Kn1ghtHOK/random/README.md

# random

## [MIB Neuralizer](neuralizer/): 3D-printable, light-up, no hardware

A parametric Men in Black neuralizer for a Bambu Lab P1S in PETG:
- **Sleeve:** the fluted sleeve slides open and a clear window under the dome glows red.
- **Button:** press HOURS for a white flash through the same window.
- **Hardware:** printed threads, snap-fits and a printed battery spring. No screws, springs, magnets or glue.

| | |
|---|---|
| **Print** | [`neuralizer/3mf/neuralizer_P1S_PETG_project.3mf`](neuralizer/3mf/neuralizer_P1S_PETG_project.3mf): Bambu Studio project with 5 plates and AMS slots 1 white / 2 black / 3 clear. Per-part 3MFs are in [`neuralizer/3mf/parts`](neuralizer/3mf/parts). |
| **Assemble** | [neuralizer/ASSEMBLY.md](neuralizer/ASSEMBLY.md): 11 illustrated steps |
| **Details** | [neuralizer/BUILD_GUIDE.md](neuralizer/BUILD_GUIDE.md): assumptions, shopping list, wiring, finish, fit tuning |
| **Proof** | [neuralizer/VERIFICATION.md](neuralizer/VERIFICATION.md): collisions, threads, mechanisms, overhangs, 3MF validation |
| **Model** | [neuralizer/neuralizer.scad](neuralizer/neuralizer.scad) (OpenSCAD Customizer) |

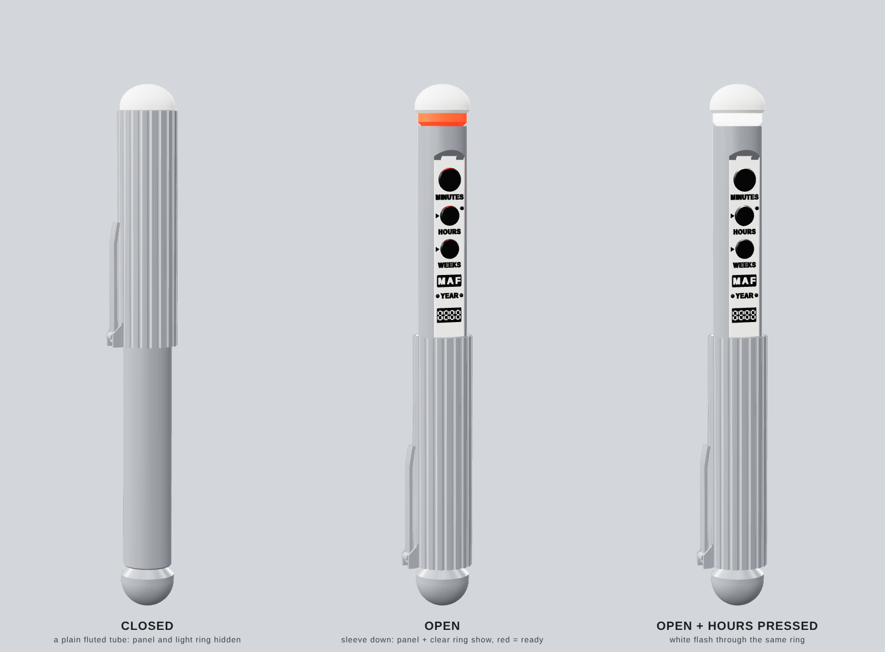
[picture p1: neuralizer/images/preview_closed_open.png]
preview
