Kn1ghtHOK/random/neuralizer/images/window_and_back.png

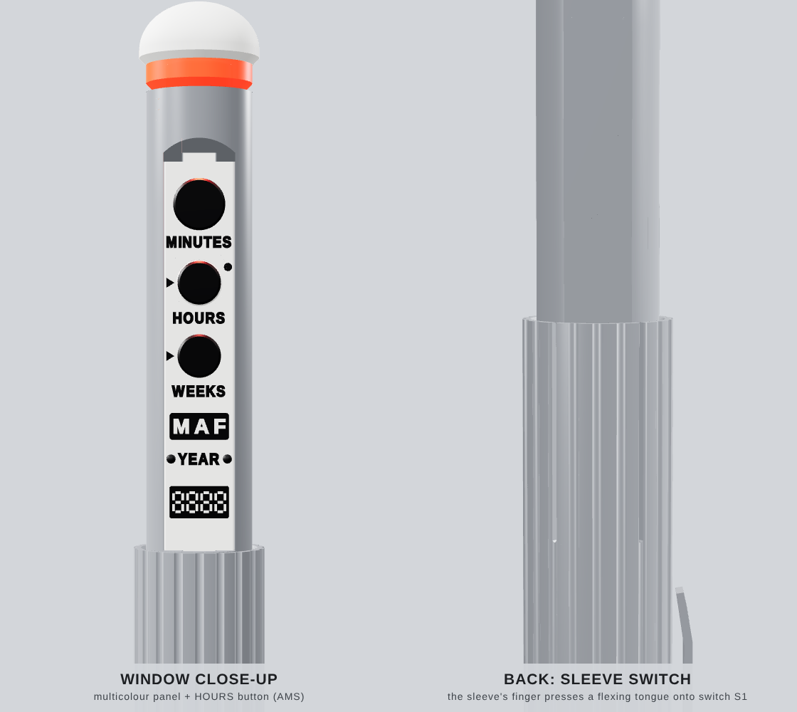
neuralizer/images/window_and_back.png
