Kn1ghtHOK/random/neuralizer/3mf/neuralizer_P1S_PETG_project.3mf

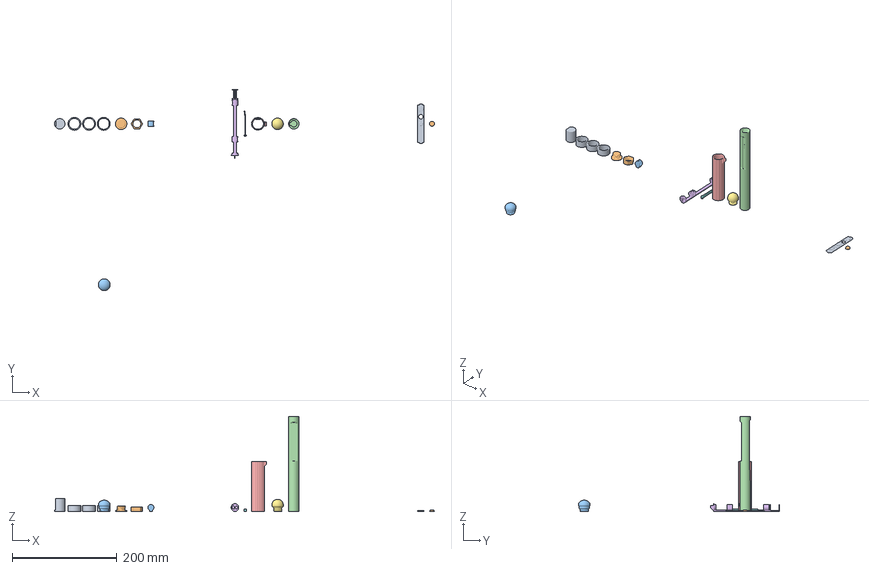
[picture p3: CAD file, 2026-10-30]
neuralizer/3mf/neuralizer_P1S_PETG_project.3mf
725.6 x 384.3 x 181.7 mm
fit_test
thread_test
switch_test
sleeve
sled
bottom_cap
clip
window_panel
btn_hours
top_cap
