Kn1ghtHOK/random/neuralizer/3mf/parts/top_cap.3mf

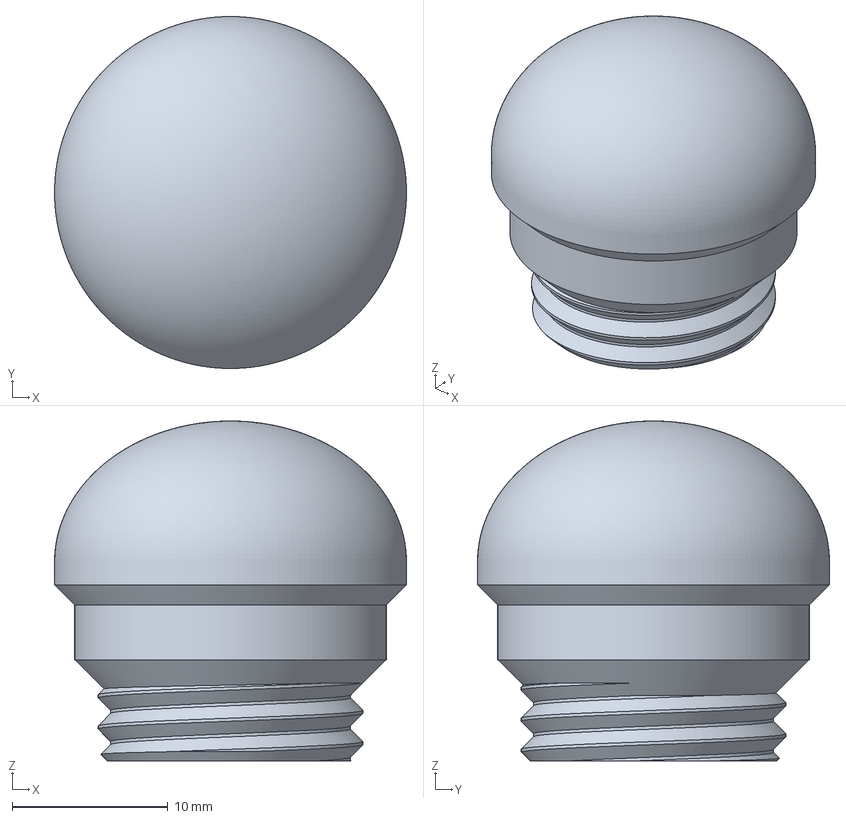
[picture p4: CAD file, 2026-10-30]
neuralizer/3mf/parts/top_cap.3mf
22.6 x 22.6 x 21.8 mm
