Kn1ghtHOK/random/neuralizer/stl/window_panel_base.stl

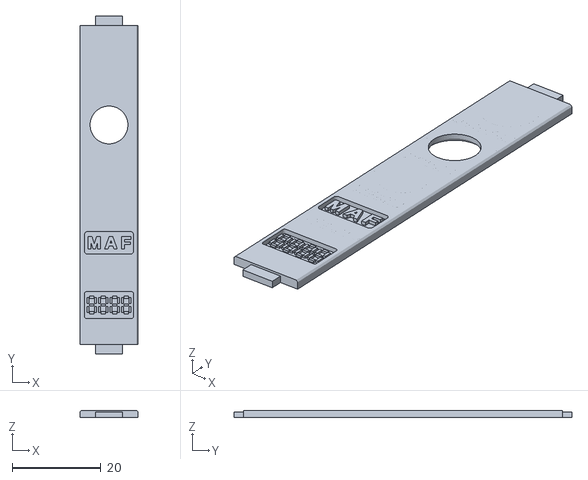
[picture p5: CAD file, 2026-10-30]
neuralizer/stl/window_panel_base.stl
13.0 x 76.0 x 1.61
