Kn1ghtHOK/random/neuralizer/3mf/parts/sled.3mf

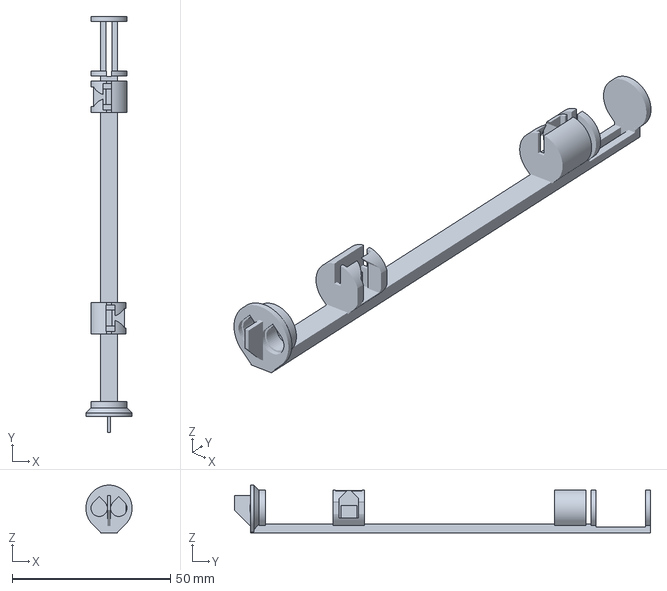
[picture p6: CAD file, 2026-10-30]
neuralizer/3mf/parts/sled.3mf
14.6 x 131.6 x 15.1 mm
