Kn1ghtHOK/random/neuralizer/stl/top_cap_clear.stl

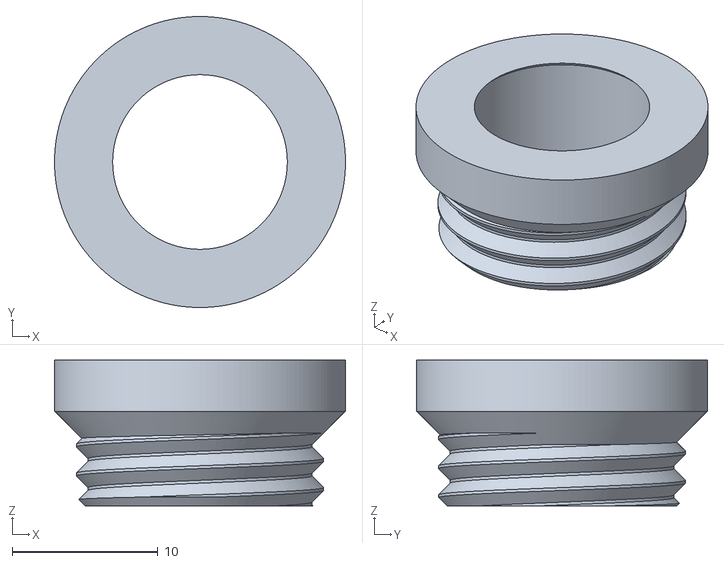
[picture p7: CAD file, 2026-10-30]
neuralizer/stl/top_cap_clear.stl
20.0 x 20.0 x 10.0
