Kn1ghtHOK/random/neuralizer/3mf/parts/bottom_cap.3mf

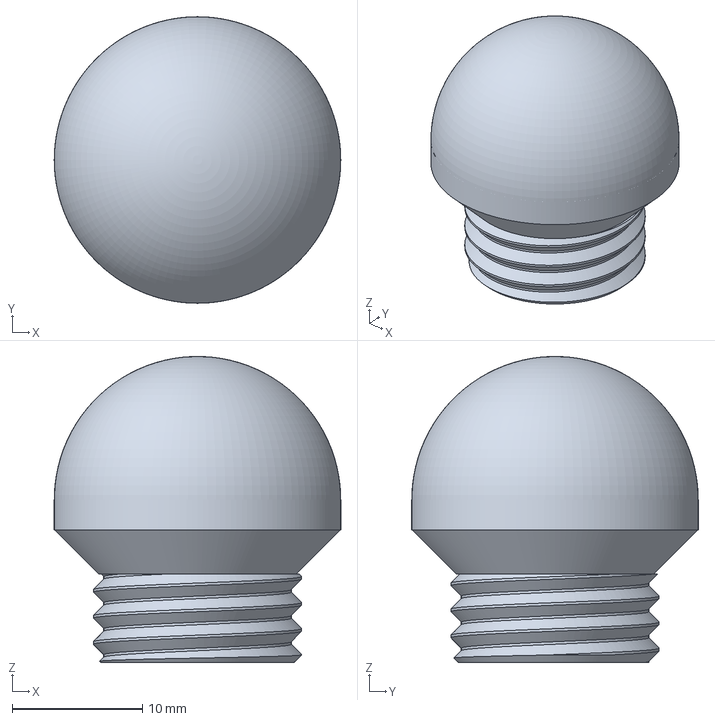
[picture p8: CAD file, 2026-10-30]
neuralizer/3mf/parts/bottom_cap.3mf
22.0 x 22.0 x 23.5 mm
