Kn1ghtHOK/random/neuralizer/stl/btn_hours_base.stl

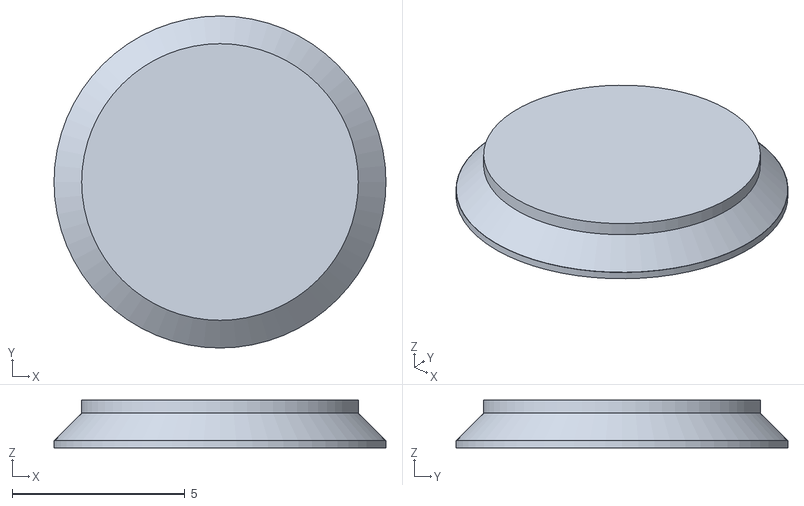
[picture p9: CAD file, 2026-10-29]
neuralizer/stl/btn_hours_base.stl
9.60 x 9.60 x 1.38
