Kn1ghtHOK/random/neuralizer/3mf/parts/clip.3mf

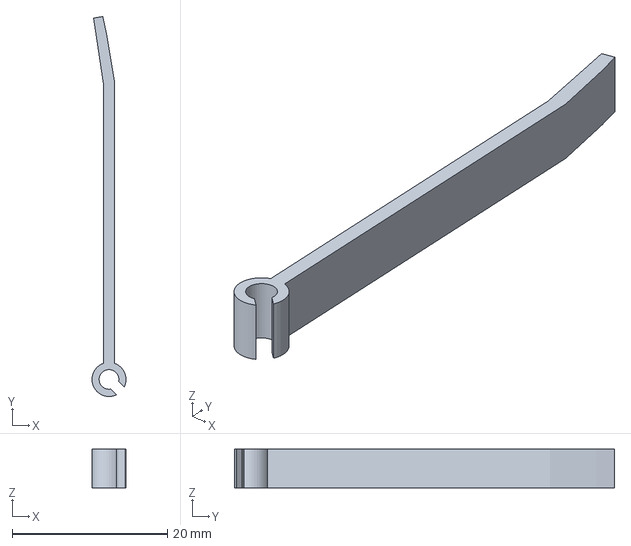
[picture p10: CAD file, 2026-10-30]
neuralizer/3mf/parts/clip.3mf
4.40 x 49.0 x 5.00 mm
