Kn1ghtHOK/random/neuralizer/stl/btn_hours_top.stl

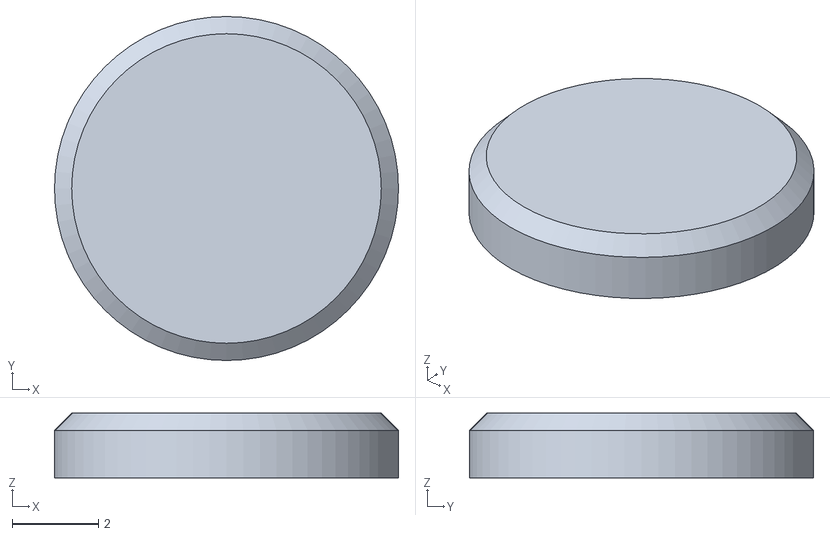
[picture p11: CAD file, 2026-10-29]
neuralizer/stl/btn_hours_top.stl
8.00 x 8.00 x 1.50
