Kn1ghtHOK/random/neuralizer/3mf/parts/body.3mf

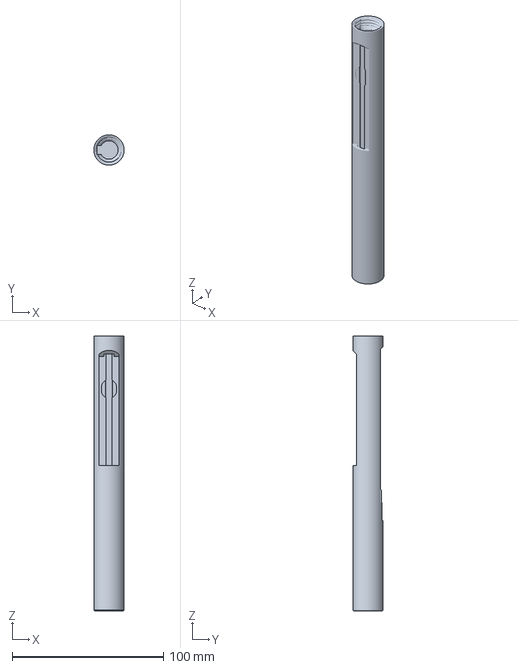
[picture p12: CAD file, 2026-10-30]
neuralizer/3mf/parts/body.3mf
20.0 x 20.0 x 181.7 mm
