Kn1ghtHOK/random/neuralizer/stl/top_cap_white.stl

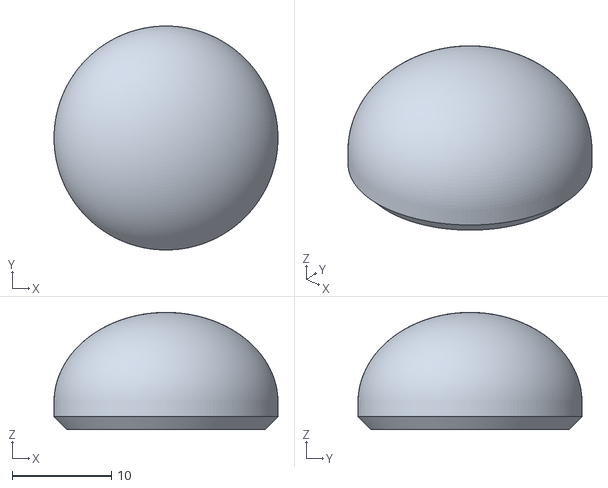
[picture p13: CAD file, 2026-10-29]
neuralizer/stl/top_cap_white.stl
22.6 x 22.6 x 11.8
