Kn1ghtHOK/random/neuralizer/3mf/parts/btn_hours.3mf

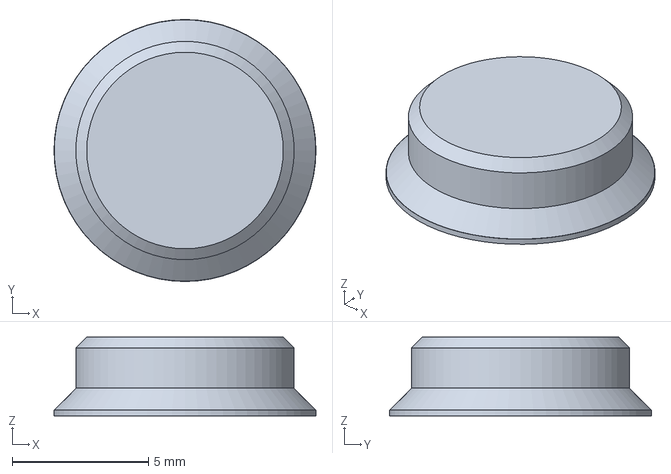
[picture p14: CAD file, 2026-10-30]
neuralizer/3mf/parts/btn_hours.3mf
9.60 x 9.60 x 2.88 mm
