Kn1ghtHOK/random/neuralizer/stl/window_panel_details.stl

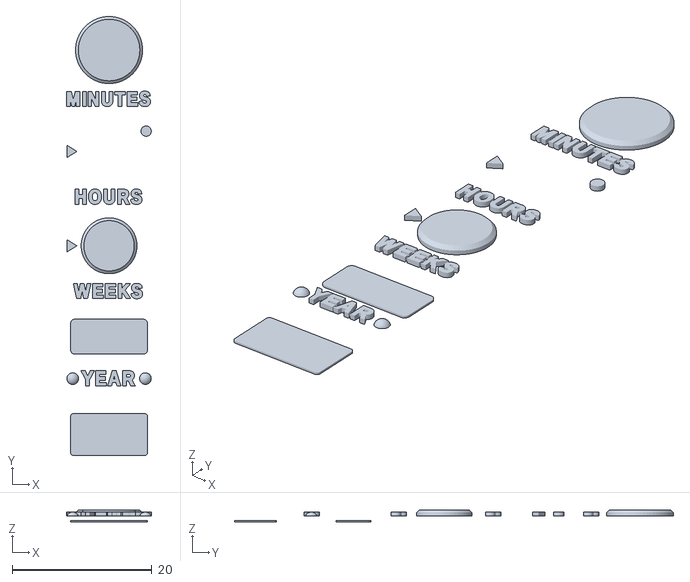
[picture p15: CAD file, 2026-10-29]
neuralizer/stl/window_panel_details.stl
12.1 x 62.8 x 1.73
