Kn1ghtHOK/random/neuralizer/3mf/parts/fit_test.3mf

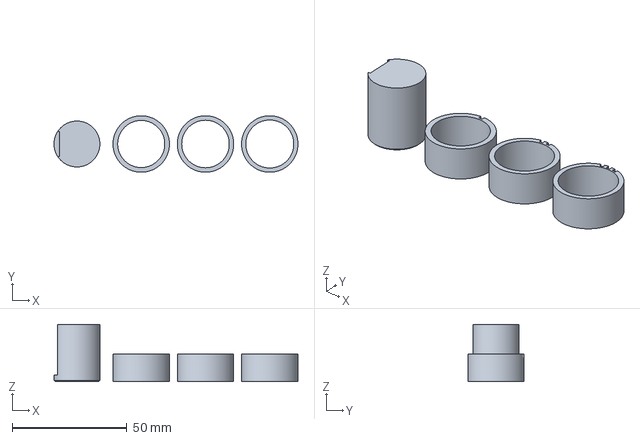
[picture p16: CAD file, 2026-10-30]
neuralizer/3mf/parts/fit_test.3mf
106.3 x 24.6 x 25.0 mm
