Kn1ghtHOK/random/neuralizer/3mf/parts/switch_test.3mf

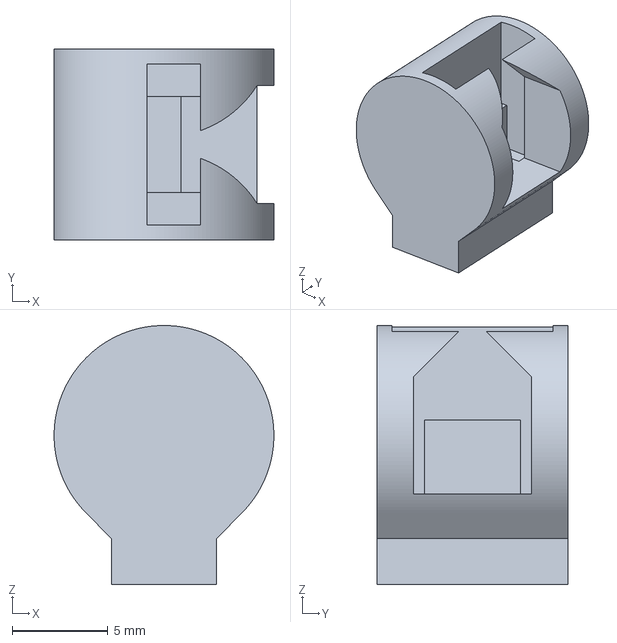
[picture p17: CAD file, 2026-10-30]
neuralizer/3mf/parts/switch_test.3mf
11.5 x 10.0 x 13.6 mm
