Kn1ghtHOK/random/neuralizer/3mf/parts/window_panel.3mf

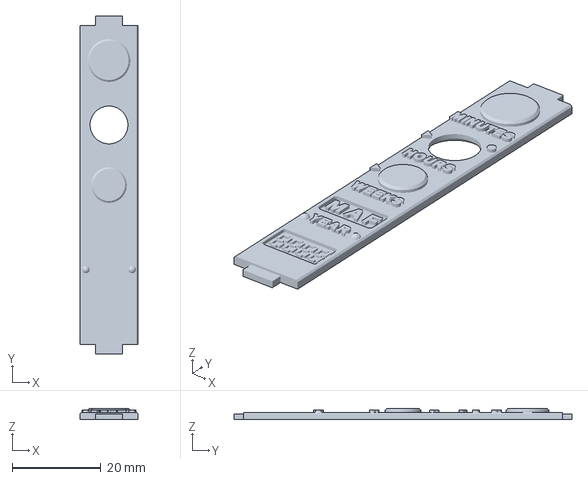
[picture p18: CAD file, 2026-10-30]
neuralizer/3mf/parts/window_panel.3mf
13.0 x 76.0 x 2.49 mm
