Kn1ghtHOK/random/neuralizer/3mf/parts/thread_test.3mf

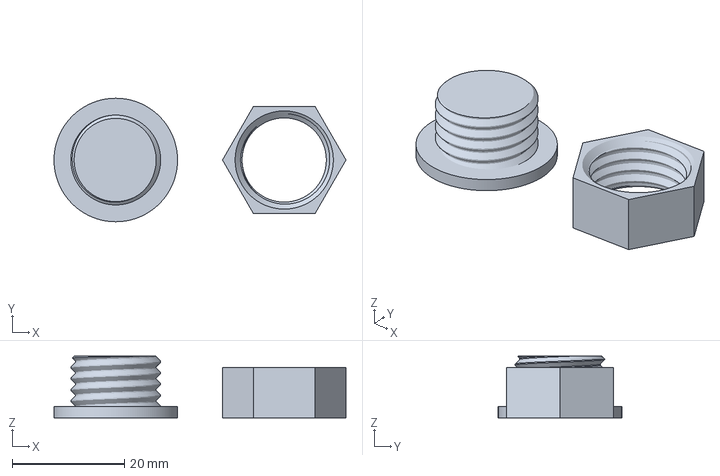
[picture p19: CAD file, 2026-10-30]
neuralizer/3mf/parts/thread_test.3mf
52.0 x 22.0 x 11.0 mm
