Kn1ghtHOK/random/neuralizer/3mf/parts/sleeve.3mf

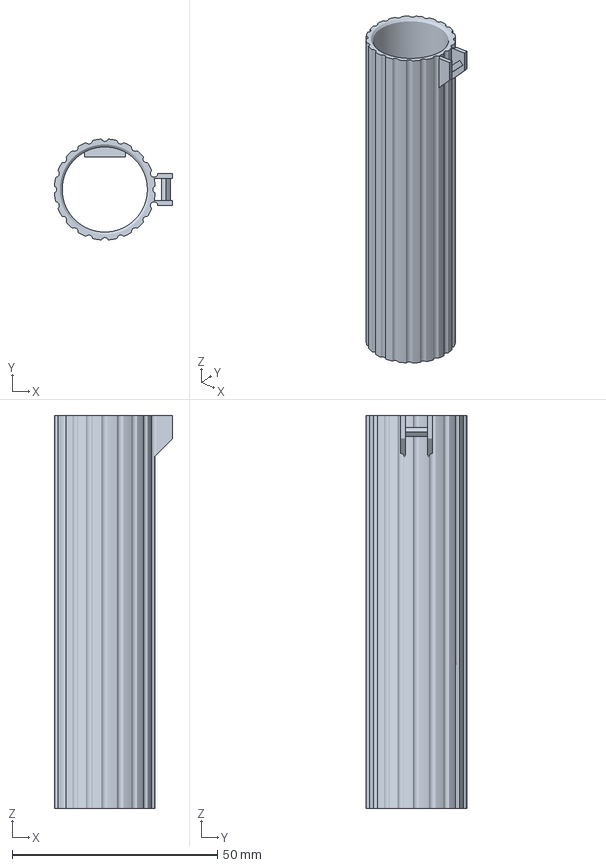
[picture p20: CAD file, 2026-10-30]
neuralizer/3mf/parts/sleeve.3mf
28.8 x 24.5 x 95.7 mm
