Kn1ghtHOK/random/(list of files, cad)

Other CAD files:
neuralizer/stl/body.stl
neuralizer/stl/bottom_cap.stl
neuralizer/stl/btn_hours.stl
neuralizer/stl/clip.stl
neuralizer/stl/fit_test.stl
neuralizer/stl/sled.stl
neuralizer/stl/sleeve.stl
neuralizer/stl/switch_test.stl
neuralizer/stl/thread_test.stl
neuralizer/stl/top_cap.stl
neuralizer/stl/window_panel.stl
