Kn1ghtHOK/random/neuralizer/images/assembly/step_03.png

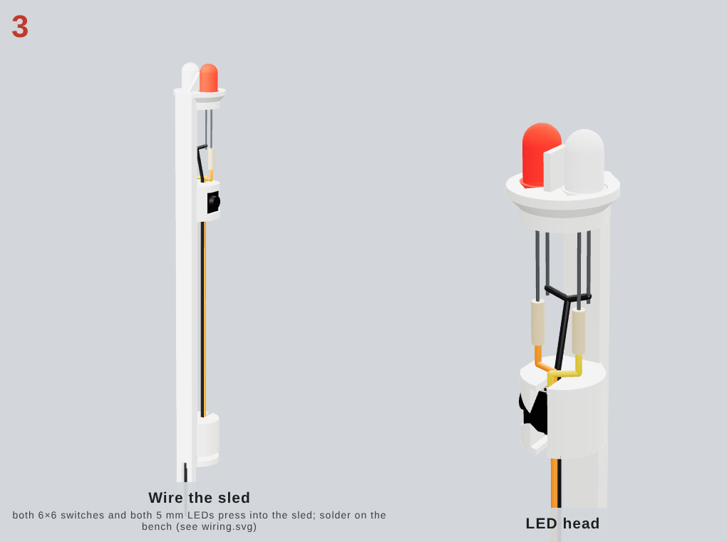
neuralizer/images/assembly/step_03.png
