Kn1ghtHOK/random/neuralizer/VERIFICATION.md

# Verification report

Generated by `tools/verify.py` from the exported STLs (battery `LR44x3`).

## 1. Printable parts: closed solids, on the bed, fit the P1S

| part | size X×Y×Z (mm) | volume (cm³) | watertight | fits 256³ |
|---|---|---|---|---|
| body | 20.0×20.0×181.6 | 31.93 | yes | yes |
| bottom_cap | 22.0×22.0×23.5 | 5.82 | yes | yes |
| btn_hours | 9.6×9.6×2.9 | 0.16 | yes | yes |
| btn_hours_base | 9.6×9.6×1.4 | 0.08 | yes | yes |
| btn_hours_top | 8.0×8.0×1.5 | 0.07 | yes | yes |
| clip | 4.4×49.0×5.0 | 0.36 | yes | yes |
| fit_test | 106.3×24.6×25.0 | 12.35 | yes | yes |
| sled | 14.6×131.6×15.1 | 3.83 | yes | yes |
| sleeve | 24.5×28.8×95.7 | 12.06 | yes | yes |
| switch_test | 11.5×10.0×13.5 | 0.84 | yes | yes |
| thread_test | 52.0×22.0×11.0 | 3.40 | yes | yes |
| top_cap | 22.6×22.6×21.8 | 4.54 | yes | yes |
| top_cap_clear | 20.0×20.0×10.0 | 1.29 | yes | yes |
| top_cap_white | 22.6×22.6×11.8 | 3.25 | yes | yes |
| window_panel | 13.0×76.0×2.5 | 1.50 | yes | yes |
| window_panel_base | 13.0×76.0×1.6 | 1.33 | yes | yes |
| window_panel_details | 12.1×62.8×1.7 | 0.17 | yes | yes |
PASS  multicolour window panel: white base + black labels/buttons: 1331 + 169 mm³ = 1500 mm³, no overlap, nothing missing
PASS  multicolour top cap: clear spigot + ring, white dome: 1292 + 3251 mm³ = 4543 mm³, no overlap, nothing missing
PASS  multicolour HOURS button: white core, black top: 82 + 73 mm³ = 156 mm³, no overlap, nothing missing

## 2. Support-free check (print orientation, tools/printcheck.py)

Strict rules, so no part needs supports or a bridge:
- **overhangs:** no down-facing surface flatter than 45° (normal_z < −0.72) above the first layer;
  only patches narrower than 0.6 mm are tolerated (the nozzle prints straight over them).
- **floating islands:** each part is sliced every 0.2 mm; every region of a layer must sit on
  the layer below (this is what Bambu Studio warns about as floating / needs support).

| part | overhang patches | floating islands | verdict |
|---|---|---|---|
| body | 0 | 0 | OK, no supports |
| bottom_cap | 0 | 0 | OK, no supports |
| btn_hours | 0 | 0 | OK, no supports |
| clip | 0 | 0 | OK, no supports |
| fit_test | 0 | 0 | OK, no supports |
| sled | 0 | 0 | OK, no supports |
| sleeve | 0 | 0 | OK, no supports |
| switch_test | 0 | 0 | OK, no supports |
| thread_test | 0 | 0 | OK, no supports |
| top_cap | 0 | 0 | OK, no supports |
| window_panel | 0 | 0 | OK, no supports |

## 3. Collision matrix (assembly coordinates)

**Sleeve OPEN** — 13 solids, 78 pairs checked.

- expected: **body ↔ sleeve_open** 39.00 mm³ (x -9.3…-7.8, z 71.7…78.6) — sleeve bump pressing the switch tongue's pad (the tongue flexes and clicks S1)
- expected: **sled ↔ cells** 41.20 mm³ (x -5.8…5.8, z 67.5…68.0) — battery bulkheads pre-loaded 0.5 mm on the cell stack (they flex = battery spring)

**Sleeve CLOSED** — 13 solids, 78 pairs checked.

- expected: **sled ↔ cells** 41.20 mm³ (x -5.8…5.8, z 67.5…68.0) — battery bulkheads pre-loaded 0.5 mm on the cell stack (they flex = battery spring)

PASS  no unintended collisions in the OPEN or CLOSED position
PASS  OPEN: the only sleeve↔body overlap is the bump on the tongue pad, 1.00 mm (= pad_press)
PASS  CLOSED: sleeve touches nothing (bump rests above the detent ridge)

## 4. Threads

PASS  Bottom cap ↔ body (Ø16 × 2 mm): screwing off along the helix (4 turns, every 30°) — max overlap 0.000 mm³ (clearance all the way)
PASS  Bottom cap ↔ body (Ø16 × 2 mm): pulling straight off by half a pitch WITHOUT turning collides (20 mm³) → the teeth interlock
PASS  Bottom cap ↔ body (Ø16 × 2 mm): turning 90° WITHOUT advancing collides (9 mm³) → pitch/handedness match
PASS  Bottom cap ↔ body (Ø16 × 2 mm): radial tooth engagement 0.51 mm, flank clearance 0.25 mm
PASS  Top cap ↔ body (Ø17 × 2 mm): screwing off along the helix (3 turns, every 30°) — max overlap 0.000 mm³ (clearance all the way)
PASS  Top cap ↔ body (Ø17 × 2 mm): pulling straight off by half a pitch WITHOUT turning collides (14 mm³) → the teeth interlock
PASS  Top cap ↔ body (Ø17 × 2 mm): turning 90° WITHOUT advancing collides (7 mm³) → pitch/handedness match
PASS  Top cap ↔ body (Ø17 × 2 mm): radial tooth engagement 0.51 mm, flank clearance 0.25 mm
PASS  top cap: its spigot lands on the sled flange (clamps the electronics sled when screwed home)

## 5. Mechanism checks

PASS  wiring (4 wires, 2 resistors, LED legs as built) stays inside the body's bore
PASS  the one wire that passes the cells (B−) runs in the channel under them, clear of the cells
PASS  electronics sled (with cells, both switches, LEDs and all the wiring) slides out of the body over its full 127 mm, checked every 2 mm — max overlap 0.000 mm³
PASS  sled is keyed: rotated 180° it does not fit (it can only go in the right way round)
PASS  S1 (6×6 tactile incl. trimmed legs) fits its sled pocket
PASS  S2 (6×6 tactile incl. trimmed legs) fits its sled pocket
PASS  HOURS at rest: 0.02 mm above the S2 plunger (no preload)
PASS  HOURS pressed: pushes the plunger 0.35 mm (≥ 0.25 travel → it clicks), then stops on the window floor
PASS  HOURS pressed: no contact with the body (stops on its flange ledges)
PASS  HOURS pressed: no contact with the window panel (stops on its flange ledges)
PASS  HOURS button is captive behind the panel
PASS  S1 plunger rests 0.05 mm behind the tongue (free when the sleeve is not fully open)
PASS  S1 with a 163 gf switch: finger k=8.6 N/mm, tongue k=2.0 N/mm, overlap 1 mm → tongue moves 0.66 mm, plunger 0.61 mm (≥ 0.25) → clicks
PASS  S1 with a 255 gf switch: finger k=8.6 N/mm, tongue k=2.0 N/mm, overlap 1 mm → tongue moves 0.57 mm, plunger 0.52 mm (≥ 0.25) → clicks
PASS  S1 with a 357 gf switch: finger k=8.6 N/mm, tongue k=2.0 N/mm, overlap 1 mm → tongue moves 0.48 mm, plunger 0.43 mm (≥ 0.25) → clicks
PASS  half-open: the bump is off the pad → S1 released (lights only at full open)
PASS  closed detent: 1.6 mm toward open the bump climbs the ridge (1.02 mm³) → holds closed
PASS  open stop: the bump hits the channel end wall
PASS  closed stop: the sleeve's top edge lands on the dome's 45° lip
PASS  CLOSED: sleeve covers the panel AND the clear ring (z 92.2…187.8 ⊇ 96.2…186.8): a plain fluted tube
PASS  OPEN: sleeve top at z=96.2 ≤ window bottom 96.2: ring and panel fully visible
PASS  clip: snap opening 1.40 mm < bar 1.58 mm → clicks on and stays
PASS  clip (open) clear of the sleeve
PASS  clip (closed) clear of the sleeve
PASS  battery: LR44x3 stack clamped between the sprung bulkheads (0.5 mm preload)
PASS  red LED tip z=184.3 sits inside the clear ring (181.8…186.8)
PASS  white LED tip z=184.3 sits inside the clear ring (181.8…186.8)

## 6. Raised detail stroke widths (window panel)

PASS  label MINUTES: 7 separate letters (expected 7) - letters do not fuse
PASS  label MINUTES: 12.0 mm wide, fits the 13 mm panel
PASS  label HOURS: 5 separate letters (expected 5) - letters do not fuse
PASS  label HOURS: 9.6 mm wide, fits the 13 mm panel
PASS  label WEEKS: 5 separate letters (expected 5) - letters do not fuse
PASS  label WEEKS: 9.9 mm wide, fits the 13 mm panel
PASS  label YEAR: 4 separate letters (expected 4) - letters do not fuse
PASS  label YEAR: 7.8 mm wide, fits the 13 mm panel
PASS  raised labels / arrows / dots: 28 features, every one keeps ≥ 92% of its area under a 0.42 mm line sweep (none thinner than a 0.4 mm nozzle line); median stroke 0.60 mm
PASS  M A F letters (inside recessed plate): 3 features, every one keeps ≥ 98% of its area under a 0.42 mm line sweep (none thinner than a 0.4 mm nozzle line); median stroke 0.74 mm
PASS  8888 display segments: 28 features, every one keeps ≥ 89% of its area under a 0.42 mm line sweep (none thinner than a 0.4 mm nozzle line); median stroke 0.55 mm

## Summary

**ALL CHECKS PASSED**

## 7. 3MF files (tools/check_3mf.py)

PASS  lib3mf strict read neuralizer_P1S_PETG_project.3mf: 11 build items, 110984 triangles, 0 warnings
PASS  lib3mf strict read body.3mf: 1 build items, 14488 triangles, 0 warnings
PASS  lib3mf strict read bottom_cap.3mf: 1 build items, 11788 triangles, 0 warnings
PASS  lib3mf strict read btn_hours.3mf: 1 build items, 1144 triangles, 0 warnings
PASS  lib3mf strict read clip.3mf: 1 build items, 296 triangles, 0 warnings
PASS  lib3mf strict read fit_test.3mf: 1 build items, 6188 triangles, 0 warnings
PASS  lib3mf strict read sled.3mf: 1 build items, 4862 triangles, 0 warnings
PASS  lib3mf strict read sleeve.3mf: 1 build items, 3792 triangles, 0 warnings
PASS  lib3mf strict read switch_test.3mf: 1 build items, 792 triangles, 0 warnings
PASS  lib3mf strict read thread_test.3mf: 1 build items, 14580 triangles, 0 warnings
PASS  lib3mf strict read top_cap.3mf: 1 build items, 21810 triangles, 0 warnings
PASS  lib3mf strict read window_panel.3mf: 1 build items, 31244 triangles, 0 warnings
PASS  Application tag ['BambuStudio-02.08.04.57'] -> Bambu Studio opens it as a PROJECT (plates + filaments), not geometry only
PASS  project config: printer Bambu Lab P1S 0.4 nozzle, process 0.16mm Optimal @BBL X1C, filaments ['Generic PETG', 'Generic PETG', 'Generic PETG'] colours ['#F2F2F2', '#161616', '#D6EAF2']
PASS  every per-filament option has 3 entries (76 filament options)
PASS  filament_extruder_variant (3) and filament_self_index (3) match the 3 filaments (Bambu rejects the file otherwise)
PASS  every <part> in model_settings matches a component of its object (Bambu maps parts by sub-object id)
PASS  all extruder assignments are within the 3 filament slots
PASS  all per-object setting keys exist in Bambu's PrintConfig
PASS  4 plates defined: 1 - Test prints - print first (white); 2 - White parts; 3 - Window panel + HOURS button - AMS white + black; 4 - Top cap - AMS clear + white
PASS  plate 1: fit_test, thread_test, switch_test - inside the 256×256 bed, no overlaps, filament slot(s) ['1']
PASS  plate 2: body, sleeve, sled, bottom_cap, clip - inside the 256×256 bed, no overlaps, filament slot(s) ['1']
PASS  plate 3: window_panel, btn_hours - inside the 256×256 bed, no overlaps, filament slot(s) ['1', '2']
PASS  plate 4: top_cap - inside the 256×256 bed, no overlaps, filament slot(s) ['1', '3']
PASS  fit_test: mesh(es) in the 3MF are watertight and identical to the verified STL (1 part)
PASS  thread_test: mesh(es) in the 3MF are watertight and identical to the verified STL (1 part)
PASS  switch_test: mesh(es) in the 3MF are watertight and identical to the verified STL (1 part)
PASS  body: mesh(es) in the 3MF are watertight and identical to the verified STL (1 part)
PASS  sleeve: mesh(es) in the 3MF are watertight and identical to the verified STL (1 part)
PASS  sled: mesh(es) in the 3MF are watertight and identical to the verified STL (1 part)
PASS  bottom_cap: mesh(es) in the 3MF are watertight and identical to the verified STL (1 part)
PASS  clip: mesh(es) in the 3MF are watertight and identical to the verified STL (1 part)
PASS  window_panel: mesh(es) in the 3MF are watertight and identical to the verified STL (2 parts)
PASS  btn_hours: mesh(es) in the 3MF are watertight and identical to the verified STL (2 parts)
PASS  top_cap: mesh(es) in the 3MF are watertight and identical to the verified STL (2 parts)
