Kn1ghtHOK/random/(commit log)

2026-10-28 Add printable MIB neuralizer: parametric OpenSCAD model, STLs, build guide, verification
    - neuralizer.scad: parametric model (battery type, tactile switch size, PETG
    clearances), support-free parts, printed threads, sliding sleeve switch with
    copper-tape pads + fallback tactile pocket, LED head with baffle
    - stl/: 13 print-ready parts in print orientation + fit/thread test prints
    - tools/verify.py: collision matrix (open/closed), thread screw-path proof,
    mechanism, overhang, bed-fit and text stroke-width checks -> VERIFICATION.md
    - BUILD_GUIDE.md: assumptions, shopping list, print plan, wiring, assembly,
    sliding-fit tuning; images/ with previews, cutaway, wiring, paint guide
    Co-Auth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
    [battery_spring.stl, body.stl, bottom_cap.stl, btn_hours.stl, btn_minutes.stl, btn_weeks.stl, clip.stl, dome.stl]
2026-10-29 Neuralizer: Bambu 3MF project (multicolour, 5 plates), clear light window top, assembly tutorial
    - New top: white dome + clear light-window ring both LEDs shine through
    (red = ready, white = flash); LED head is now a white reflector
    - Multicolour window panel (white + black labels/plates) split with exact
    booleans for the AMS
    - 3mf/neuralizer_P1S_PETG_project.3mf: Bambu Studio project with 5 plates,
    3 filament slots, per-object print settings, plate thumbnails; plus one
    plain 3MF per part. Format mirrors Bambu's bbs_3mf exporter; validated
    with lib3mf (strict) and tools/check_3mf.py
    - Higher mesh resolution (0.35 mm facets) for a smooth chrome finish
    - ASSEMBLY.md with 11 rendered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
    [battery_spring.3mf, battery_spring.stl, body.3mf, body.stl, bottom_cap.3mf, bottom_cap.stl, btn_hours.3mf, btn_hours.stl]
2026-10-29 Neuralizer: electronics sled for ~20 min assembly; sleeve hides the light ring
    - All electronics (both switches, LEDs, resistors, cells) mount on one printed sled
    that is wired on the bench and slides into the body from the top; the top cap
    clamps it. No copper tape, no wires threaded through the body.
    - Sleeve switch is a 6x6 tactile on the sled, pressed through a flexing tongue in
    the body wall by the sleeve finger at full open.
    - Closed sleeve now covers the window panel and the clear light ring.
    - Top cap is one AMS part (clear spigot + light ring, white dome).
    - HOURS button flange rides in a recess in the panel back so the sled can be
    pulled out past it for battery changes.
    - 3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
    [battery_spring.3mf, battery_spring.stl, body.3mf, body.stl, bottom_cap.3mf, bottom_cap.stl, btn_hours.3mf, btn_hours.stl]
2026-10-29 Neuralizer docs: switches are the user's own; shopping list is batteries only
    Claude-Session: https://claude.ai/code/session_01SXNnEkC5JFvA7DVhwjrA6j
2026-10-29 Neuralizer 3MF: write filament_self_index so Bambu Studio accepts the project
    Bambu Studio compares filament_extruder_variant with filament_self_index when it
    loads a project; the missing key defaulted to [1] against 3 filaments and the
    load failed with "Invalid configuration file". Reproduced and verified with
    Bambu Studio's own config loader; check_3mf.py now guards the rule.
    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
    [body.3mf, bottom_cap.3mf, btn_hours.3mf, clip.3mf, fit_test.3mf, neuralizer_P1S_PETG_project.3mf, sled.3mf, sleeve.3mf]
2026-10-29 Neuralizer: lever microswitch for the sleeve, fully support-free parts
    - Sleeve switch is now a subminiature lever microswitch on the sled (lever tip
    snipped), pressed through the body's flexing tongue; HOURS keeps the 6x6
    tactile switch. Both switch sizes are parameters.
    - Every part passes a strict support-free check (tools/printcheck.py): no
    down-facing surface flatter than 45 deg and no floating islands. Sled
    sections get a 45 deg keel, horizontal holes are teardrops, slot roofs are
    gabled, the HOURS button sits in a 45 deg countersink instead of a bridged
    recess, the clip hinge bar is a diamond.
    - Wires run in grooves along the spine, under the cells.
    - New switch_test print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
    [body.3mf, body.stl, bottom_cap.3mf, bottom_cap.stl, btn_hours.3mf, btn_hours.stl, btn_hours_base.stl, btn_hours_top.stl]
2026-10-29 Neuralizer: both switches are 6x6 tactile again, keeping the support-free parts
    - The sleeve switch goes back to a 6x6 tactile switch in a mirrored copy of
    the HOURS holder (one shared holder module), pressed through the body's
    flexing tongue; all lever-microswitch code and docs removed.
    - Every part still passes the strict support-free check.
    - Docs: 5 mm LED spec and shopping-list line, switch test for the 6x6 holder.
    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
    [body.3mf, body.stl, bottom_cap.3mf, bottom_cap.stl, btn_hours.3mf, btn_hours.stl, clip.3mf, fit_test.3mf]
2026-10-30 Neuralizer sled: real wire paths, batteries at the bottom
    The previous sled had no usable wire path: the only channels were two 1 mm
    grooves on the spine's underside, and nothing connected the switches to them.
    - Batteries move to the bottom of the sled (below the sleeve switch), so only
    the B- wire passes the cells, in a 2 mm channel between two spine rails.
    - Open-top 1.6 mm wire slot through both switch holders; full-depth slot
    through the upper battery wall.
    - Wires, resistors and LED legs modelled; verify checks they stay inside the
    bore, clear the cells and slide out with the sled. New sled_wiring.png.
    - Assembly step 3/4, wiring diagram and preview updated.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
    [body.3mf, body.stl, bottom_cap.3mf, bottom_cap.stl, btn_hours.3mf, btn_hours.stl, clip.3mf, fit_test.3mf]
